avan411/EE310-Speed-Detector/LTSpice/Report_Design_amplification.asc

B1: bv; V={if(time<{time_change},sin(2*pi* {f1} *time)+{o1},-1*sin(2*pi* {f2} *time)+{o2})}
C1: cap; 7.5p
C2: cap; 100n
C3: cap; {C1}; Rser=10m
C4: cap; 100n
C5: cap; 390p
C6: cap; 4.7n
C7: cap; 10n
C_0: cap; 4.25p
D1: LED; KA3529
I_P: bi; I=0.55e-6*I(D1)+15e-9*white(1e8*time)
Q1: npn; BC547B
Q2: npn; BC639
R1: res; 100k
R2: res; 10k
R3: res; 39k
R4: res; 4.7k
R5: res; 1Meg
R6: res; 22k
R7: res; 1k
R8: res; {R1}
R9: res; {R2}
R10: res; {R3}
R11: res; 1k
R12: res; 18k
R13: res; 27k
R14: res; 68k
R15: res; 33k
R16: res; 33k
R17: res; 68k
R18: res; 10k
R19: res; 27k
R20: res; 1k
R21: res; 1k
R22: res; 2.2k
R23: res; 1k
R24: res; 1k
R25: res; 15.95
R26: res; 100k
R27: res; 10k
R28: res; 68k
R29: res; 1k
R_leak: res; 16.6G
U1: opamp2; LM358
U2: opamp2; LM358
U3: opamp2; LM358
U4: opamp2; LM393A
U5: opamp2; LM358
U6: opamp2; LM358
U7: opamp2; LM393A
U8: opamp2; LM393A
U9: opamp2; LM324
V1: voltage; 2.5
V3: voltage; SINE({Vin_offset} {A} {f})
V4: voltage; {Vsupply}
Named nets: 0, Vin, Vsupply, Vbias, Vdet, Vrx, Vtri, Vref, Vsq, Visc, Vpwm, Vamp, Vout, Vin1
Photo-diode
For this param, change f between 1-2.5k, Vin_offset keep between 2-3V, and keep A low (around 1V)
Example SPICE directive for obtaining harmonic components
.fourier {f} 100 V(vout)
Photo-diode
When the transmitter and receiver are 100mm apart use the equation
I=9.5e-6*I(D1)+15e-9*white(1e8*time)
 
When the transmitter and receiver are 400mm apart use the equation
I=0.55e-6*I(D1)+15e-9*white(1e8*time)
Transmitter
Receiver
.include LM393A.5_1
.include eee305.lib
.fourier {f} 100 V(vout)
15//15
.param C1=1.5n Vref=2 Vsupply=5 R1=10k R2=100k R3=250k
.model KA3529 D(Is=1.00E-20 N=1.806 Rs=2.616247 Eg=2.26 Xti=3)
27//39ohm
Triangle Waveform Generator
Input Signal Conditioner
LED Driver
PWM Generator
.model BC639 NPN (AF= 1.00E+00 BF= 1.29E+02 BR= 2.92E+00 CJC= 4.85E-11 
+ CJE= 1.17E-10 CJS= 0.00E+00 EG= 1.11E+00 FC= 5.00E-01 IKF= 9.06E-01 
+ IKR= 1.00E+00 IRB= 2.38E-02 IS= 3.06E-15 ISC= 4.08E-14   ISE= 1.62E-16 
+ ITF= 5.64E-01 KF=0.00E+00 MJC= 5.09E-01 MJE= 4.22E-01 MJS= 3.30E-01 
+ NC=1.00E+00 NE= 1.00E+00 NF= 8.55E-01 NR= 9.10E-01 PTF=0.00E+00 
+ RB= 1.65E+01 RBM= 1.73E-02 RC= 3.11E-01 RE= 1.26E-02 TF= 1.42E-09  
+ TR= 0.00E+00 VAF= 7.24E+02 VAR=5.46E+01 VJC= 3.00E-01 VJE= 3.00E-01 
+ VJS= 7.50E-01 VTF=9.99E+05 XCJC= 1.00E+00 XTB= 0.00E+00 
+ XTF= 7.75E-01 XTI=3.00E+00)
L78L05ACZ 5V DC
linear regulator
2V reference 
generator circuit
Voltage Sources/Signals
ELECTENG 310 Assignment1
Group 6
 
Thomas Cummings
Demian Pillay
Ashley v.d. Merwe
.fourier {f} 100 V(vout)
Ideally intended to be 2.35
.param f=2.5k Vin_offset=3V A=1
.tran 0 7m 3m
.param time_change=5m f1=1k f2=1k o1=1 o2=1
