avan411/EE310-Speed-Detector/Assignment 2/Assignment2.asc

C1: cap; 7.5p
C2: cap; 27n
C3: cap; {C1}; Rser=10m
C4: cap; 1µ
C5: cap; 180p
C6: cap; 680p
C_0: cap; 4.25p
D1: LED; KA3529
I_P: bi; I=9.5e-6*I(D1)+15e-9*white(1e8*time)
Q1: npn; BC547B
Q2: npn; BC639
R1: res; 100k
R2: res; 10k
R3: res; {R1}
R4: res; {R2}
R5: res; {R3}
R6: res; 1k
R8: res; 68k
R9: res; 33k
R10: res; 33k
R11: res; 68k
R12: res; 18k
R13: res; 27k
R14: res; 8.5k
R15: res; 27k
R16: res; 1k
R17: res; 1k
R18: res; 2.2k
R19: res; 1k
R20: res; 1k
R21: res; 15.95
R22: res; 39k
R24: res; 56k
R25: res; 20k
R26: res; 180k
R27: res; 180k
R28: res; 1Meg
R29: res; 1k
R30: res; 1k
R_leak: res; 16.6G
U1: opamp2; LM324
U2: opamp2; LM358
U3: opamp2; LM358
U5: opamp2; LM358
U6: opamp2; LM393A
U7: opamp2; LM393A
U8: opamp2; LM393A
U9: UniversalOpAmp2
V1: voltage; 2.5
V3: voltage; SINE({Vin_offset} {A} {f})
V4: voltage; {Vsupply}
Named nets: 0, Vin, Vsupply, Vbias, Vdet, Vout, Vrx, Vtri, Vref, Vsq, Visc, Vpwm, Vamp
.tran 0 1.5m 1m startup
.param f=2.5k Vin_offset=3V A=1
Photo-diode
For this param, change f between 1-2.5k, Vin_offset keep between 2-3V, and keep A low (around 1V)
Example SPICE directive for obtaining harmonic components
.fourier {f} 100 V(vout)
Photo-diode
When the transmitter and receiver are 100mm apart use the equation
I=9.5e-6*I(D1)+15e-9*white(1e8*time)
 
When the transmitter and receiver are 400mm apart use the equation
I=0.55e-6*I(D1)+15e-9*white(1e8*time)
Transmitter
Receiver
.include LM393A.5_1
.include eee305.lib
.fourier {f} 100 V(vdet)
15//15
.param C1=15n Vref=2 Vsupply=5 R1=1k R2=33k R3=82k
.param Vinput_frequency=1k Vinput_offset=3
.model KA3529 D(Is=1.00E-20 N=1.806 Rs=2.616247 Eg=2.26 Xti=3)
.model BC639 NPN (AF= 1.00E+00 BF= 1.29E+02 BR= 2.92E+00 CJC= 4.85E-11 
+ CJE= 1.17E-10 CJS= 0.00E+00 EG= 1.11E+00 FC= 5.00E-01 IKF= 9.06E-01 
+ IKR= 1.00E+00 IRB= 2.38E-02 IS= 3.06E-15 ISC= 4.08E-14   ISE= 1.62E-16 
+ ITF= 5.64E-01 KF=0.00E+00 MJC= 5.09E-01 MJE= 4.22E-01 MJS= 3.30E-01 
+ NC=1.00E+00 NE= 1.00E+00 NF= 8.55E-01 NR= 9.10E-01 PTF=0.00E+00 
+ RB= 1.65E+01 RBM= 1.73E-02 RC= 3.11E-01 RE= 1.26E-02 TF= 1.42E-09  
+ TR= 0.00E+00 VAF= 7.24E+02 VAR=5.46E+01 VJC= 3.00E-01 VJE= 3.00E-01 
+ VJS= 7.50E-01 VTF=9.99E+05 XCJC= 1.00E+00 XTB= 0.00E+00 
+ XTF= 7.75E-01 XTI=3.00E+00)
L78L05ACZ 5V DC
linear regulator
Voltage Sources/Signals
ELECTENG 310 Assignment1
Group 6
 
Thomas Cummings
Demian Pillay
Ashley v.d. Merwe
.ac oct 10 1 1Meg
27//39ohm
Triangle Waveform Generator
Input Signal Conditioner
LED Driver
PWM Generator
2V reference 
generator circuit
Ideally intended to be 2.35
