avan411/EE310-Speed-Detector/Assignment 1/Assignment1_Task2_2.asc

C1: cap; {C1}; Rser=10m
R1: res; {R1}
R2: res; {R2}
R3: res; {R3}
U1: LM358
U2: UniversalOpAmp2; Avol=1Meg GBW=10Meg Slew=10000Meg
V1: voltage; {Vsupply}
V2: voltage; {Vref}
Named nets: 0, Vsupply, Vtri, Vref, Vsq
.tran 0 4m 3.5m startup
.param C1=33n Vref=2.5 Vsupply=5 R1=1k R2=1k R3=2.7k
Instructions:
1. Complete the schematic by adding in an ideal op-amp as a comparator
    and a voltage source for the reference (Vref)
     1.1. To add in an ideal op-amp, press F2 > click on opamps > insert Universalopamp2
     1.2. To add a voltage source, press F2 > in the main menu select voltage
2. The universal opamp is ideal, so it should not need configuring
3. To set the reference voltage, right click on the placed voltage source 
     > in the voltage box, enter {Vref}. The use of {} allows you to set variables which is easily configurable later
     > Insert a ground to the negative terminal of the voltage source
     > Insert a 'Net Label' to the positive terminal of the voltage source, label it Vref
        This connects all the nets in the simulations labelled Vref together and makes it easy to read
4. Right click on the '.param' statement
    > fill in each of the boxes based on the assignment sheet that you have filled in so far
5. Run the simulation
.include eee305.lib
.param R1=1k R2=1k R3=2.5k C1=12n Vsupply=5 Vref=2.5
