avan411/EE310-Speed-Detector/Assignment 1/Assignment1_Task2_2_Practical no pullup.asc

C1: cap; {C1}; Rser=10m
R1: res; {R1}
R2: res; {R2}
R3: res; {R3}
U2: opamp2; LM358
U3: opamp2; LM393A
V1: voltage; {Vsupply}
V2: voltage; {Vref}
Named nets: 0, Vsupply, Vtri, Vref, Vsq
.param C1=15n Vref=2.5 Vsupply=5 R1=1k R2=3.3k R3=8.2k
.include LM393A.5_1
.param Vinput_frequency=2.5k Vinput_offset=1
.include BC639_LTSpice_Model.txt
.include KA3529_LTSpice_Model.txt
.tran 0 20m 10m
.include eee305.lib
