avan411/EE310-Speed-Detector/Assignment 1/Assignment1_Task2_2_Practical.asc

C1: cap; {C1}; Rser=10m
C2: cap; 1µ
D1: LED; KA3529
Q1: npn; BC547B
Q2: npn; BC639
R1: res; {R1}
R2: res; {R2}
R3: res; {R3}
R4: res; 1k
R5: res; 8.5k
R6: res; 3k
R7: res; 2k
R8: res; 27k
R9: res; 1k
R10: res; 68k
R11: res; 1k
R12: res; 33k
R13: res; 33k
R14: res; 68k
R15: res; 2.2k
R16: res; 1k
R17: res; 1k
R18: res; 15.95
U1: opamp2; LM358
U2: opamp2; LM358
U3: opamp2; LM393A
U4: opamp2; LM393A
V1: voltage; {Vsupply}
Vinput: voltage; SINE({Vinput_offset} 1 {Vinput_frequency})
Named nets: 0, Vsupply, Vtri, Vref, Vsq, Visc, Vpwm, Vin
.param C1=15n Vref=2 Vsupply=5 R1=1k R2=33k R3=82k
.include LM393A.5_1
.param Vinput_frequency=1k Vinput_offset=3
.tran 0 2m 1m
.include eee305.lib
.model KA3529 D(Is=1.00E-20 N=1.806 Rs=2.616247 Eg=2.26 Xti=3)
27//39ohm
Triangle Waveform Generator
Input Signal Conditioner
LED Driver
PWM Generator
.model BC639 NPN (AF= 1.00E+00 BF= 1.29E+02 BR= 2.92E+00 CJC= 4.85E-11 
+ CJE= 1.17E-10 CJS= 0.00E+00 EG= 1.11E+00 FC= 5.00E-01 IKF= 9.06E-01 
+ IKR= 1.00E+00 IRB= 2.38E-02 IS= 3.06E-15 ISC= 4.08E-14   ISE= 1.62E-16 
+ ITF= 5.64E-01 KF=0.00E+00 MJC= 5.09E-01 MJE= 4.22E-01 MJS= 3.30E-01 
+ NC=1.00E+00 NE= 1.00E+00 NF= 8.55E-01 NR= 9.10E-01 PTF=0.00E+00 
+ RB= 1.65E+01 RBM= 1.73E-02 RC= 3.11E-01 RE= 1.26E-02 TF= 1.42E-09  
+ TR= 0.00E+00 VAF= 7.24E+02 VAR=5.46E+01 VJC= 3.00E-01 VJE= 3.00E-01 
+ VJS= 7.50E-01 VTF=9.99E+05 XCJC= 1.00E+00 XTB= 0.00E+00 
+ XTF= 7.75E-01 XTI=3.00E+00)
L78L05ACZ 5V DC
linear regulator
Setup
Input Voltage signal
from speedometer
2V reference 
generator circuit
Voltage Sources/Signals
ELECTENG 310 Assignment1
Group 6
 
Thomas Cummings
Demian Pillay
Ashley v.d. Merwe
