avan411/EE310-Speed-Detector/Assignment 1/Assignment1_Task2_2_Practical2.asc

C1: cap; {C1}; Rser=10m
C2: cap; 1µ
D1: LED; KA3529
Q1: npn; BC547B
Q2: npn; BC639
R1: res; {R1}
R2: res; {R2}
R3: res; {R3}
R4: res; 1k
R5: res; 8.5k
R6: res; 1k
R7: res; 1k
R8: res; 22k
R9: res; 100
R10: res; 150k
R11: res; 1k
R12: res; 100k
R13: res; 100k
R14: res; 150k
R15: res; 2k
R16: res; 1k
R17: res; 1k
R18: res; 16
U1: opamp2; LM358
U2: opamp2; LM358
U3: opamp2; LM393A
U4: opamp2; LM393A
V1: voltage; {Vsupply}
V2: voltage; {Vref}
V3: voltage; SINE(1.75 0.5 2.5k)
Vinput: voltage; SINE({Vinput_offset} 1 {Vinput_frequency})
Named nets: 0, Vsupply, Vtri, Vref, Vsq, Vinput_conditioned, Vpwm
.param C1=15n Vref=1.75 Vsupply=5 R1=1k R2=33k R3=82k
.include LM393A.5_1
.param Vinput_frequency=2.5k Vinput_offset=1
.include BC639_LTSpice_Model.txt
.include KA3529_LTSpice_Model.txt
.tran 0 10.6m 10m
.include eee305.lib
