avan411/EE310-Speed-Detector/(list of files, drawings)

Other design files:
Altium/Receiver - Student Version/Amplifier.SchDoc
Altium/Receiver - Student Version/HP Filter.SchDoc
Altium/Receiver - Student Version/Light Detector.SchDoc
Altium/Receiver - Student Version/LP Filter.SchDoc
Altium/Receiver - Student Version/PWM Regenerator.SchDoc
Altium/Receiver - Student Version/Receiver - Student Version.PrjPcb
Altium/Receiver - Student Version/Receiver.PcbDoc
Altium/Receiver - Student Version/Receiver.SchDoc
Altium/Receiver - Student Version/Regulator.SchDoc
Altium/Transmitter - Student Version/1_Triangle Wave Generator.SchDoc
Altium/Transmitter - Student Version/2_Input Signal Conditioner.SchDoc
Altium/Transmitter - Student Version/3_PWM Generator.SchDoc
Altium/Transmitter - Student Version/4_Darlington Pair Amplifier.SchDoc
Altium/Transmitter - Student Version/5_Regulator.SchDoc
Altium/Transmitter - Student Version/EE310_example.PcbLib
Altium/Transmitter - Student Version/EE310_example.SchLib
Altium/Transmitter - Student Version/Transmitter - Student Version.PrjPcb
Altium/Transmitter - Student Version/Transmitter.PcbDoc
Altium/Transmitter - Student Version/Transmitter.SchDoc
