avan411/EE310-Speed-Detector/(commit log)

2022-04-01 added altium files
    [1_Triangle Wave Generator.SchDoc, 2_Input Signal Conditioner.SchDoc, 3_PWM Generator.SchDoc, 4_Darlington Pair Amplifier.SchDoc, 5_Regulator.SchDoc, Amplifier.SchDoc, EE310_example.PcbLib, EE310_example.SchLib]
2022-04-02 completed reciever PCB
    [Amplifier.SchDoc, HP Filter.SchDoc, LP Filter.SchDoc, Light Detector.SchDoc, PWM Regenerator.SchDoc, Receiver - Student Version.PrjPcb, Receiver.PcbDoc, Regulator.SchDoc]
2022-04-03 Completed transmitter PCB
    [1_Triangle Wave Generator.SchDoc, 2_Input Signal Conditioner.SchDoc, 3_PWM Generator.SchDoc, 4_Darlington Pair Amplifier.SchDoc, 5_Regulator.SchDoc, Transmitter - Student Version.PrjPcb, Transmitter.PcbDoc]
2022-04-04 trying out different filters
2022-04-07 transmitter completed
    [1_Triangle Wave Generator.SchDoc, 4_Darlington Pair Amplifier.SchDoc, Transmitter.PcbDoc]
2022-04-07 completed reciever completely
    [Light Detector.SchDoc, Receiver.PcbDoc]
2022-04-08 All PCBs completed
    [1_Triangle Wave Generator.SchDoc, 3_PWM Generator.SchDoc, 4_Darlington Pair Amplifier.SchDoc, 5_Regulator.SchDoc, Amplifier.SchDoc, LP Filter.SchDoc, Light Detector.SchDoc, PWM Regenerator.SchDoc]
2022-04-13 found a good filter to use for the report design. Updated values in Report LTspice design. Changed the variation in frequency .txt file
2022-04-26 Updated LTspice and Altium is changed
    [1_Triangle Wave Generator.SchDoc, 2_Input Signal Conditioner.SchDoc, 5_Regulator.SchDoc, Amplifier.SchDoc, HP Filter.SchDoc, LP Filter.SchDoc, Light Detector.SchDoc, PWM Regenerator.SchDoc]
